SamMmason/Microcontrollers-Final-Project/PXL_20251209_013349403.jpg

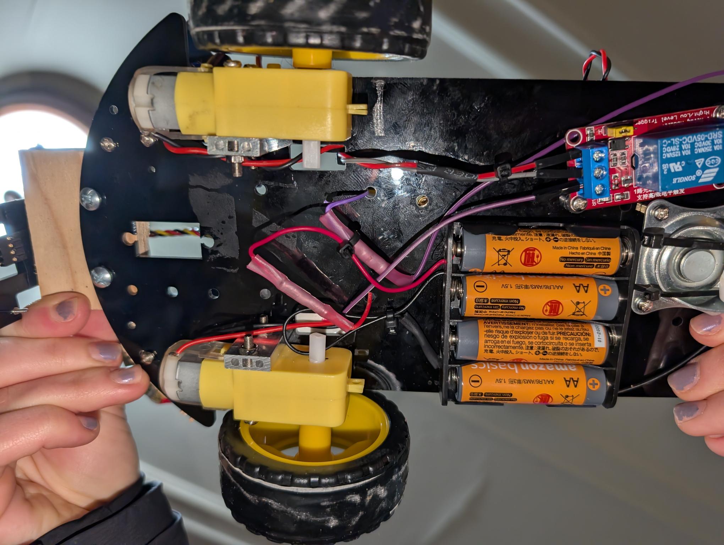
PXL_20251209_013349403.jpg
