SamMmason/Microcontrollers-Final-Project/PXL_20251208_215356275.MP.jpg

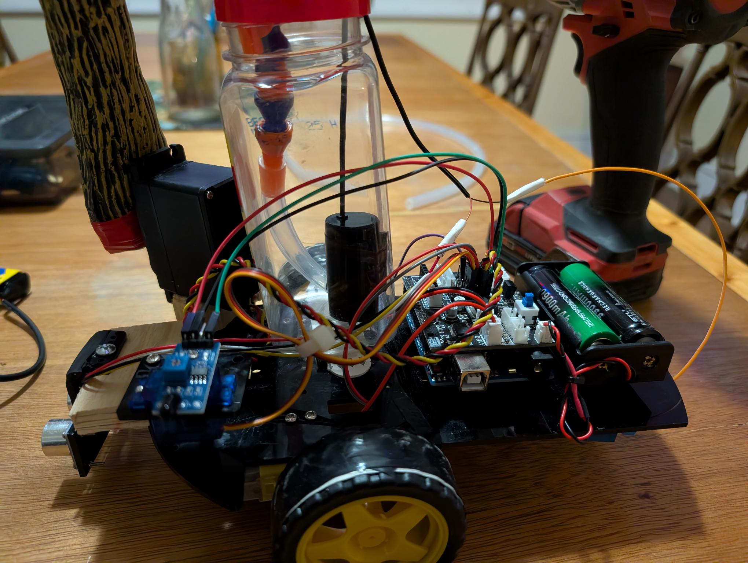
PXL_20251208_215356275.MP.jpg
