SamMmason/Microcontrollers-Final-Project/PXL_20251208_215402489.jpg

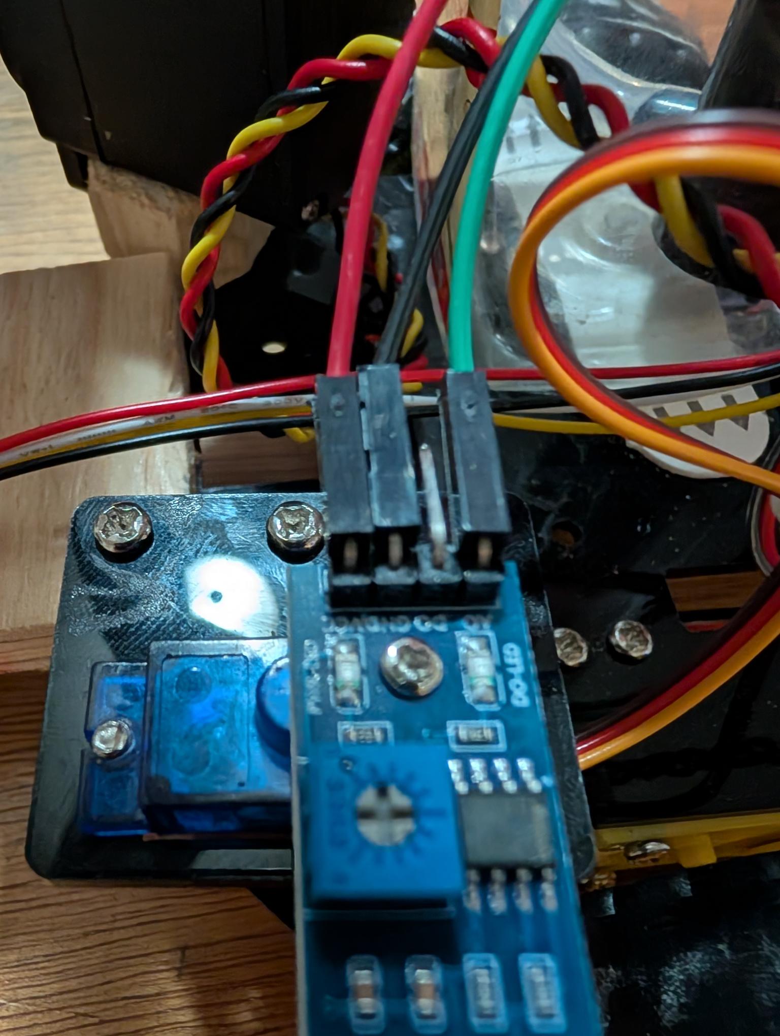
PXL_20251208_215402489.jpg
