SamMmason/Microcontrollers-Final-Project/PXL_20251208_232930272.jpg

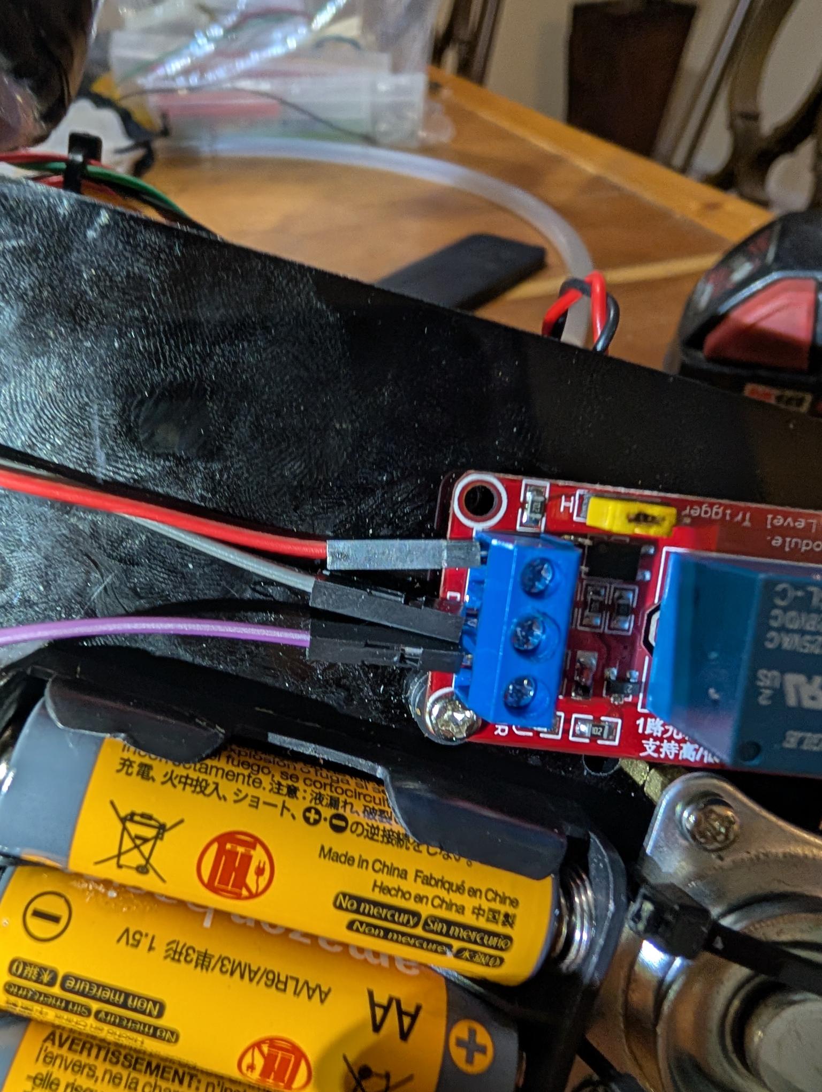
PXL_20251208_232930272.jpg
